Schenktronics/ST04-quad-mixer/docs/BOM.csv

Qty | Reference | Description | Manufacturer | Part Number | Link
1 | U1 | Quad JFET op-amp, SOIC-14. Must be the H version | Texas Instruments | TL074HIDR | https://www.ti.com/lit/ds/symlink/tl074.pdf
1 | U2 | Dual JFET op-amp, SOIC-8. Must be the H version | Texas Instruments | TL072HIDR
13 | R1-R4, R9-R17 | Resistor, 10k, 1%, 0805 | Yageo | RC0805FR-0710KL
4 | R5-R8 | Resistor, 0 ohm jumper, 0805 | Yageo | RC0805FR-070RL
6 | R18-R23 | Resistor, 1k, 1%, 0805 | Yageo | RC0805FR-071KL
4 | C1-C4 | Capacitor, 0.1uF, 25V, X7R, 0805 | AVX | 08053C104KAT2A
2 | C5, C6 | Capacitor, 10uF, 25V, X5R, 0805 | Taiyo Yuden | TMK212BBJ106KG-T
2 | C7, C8 | Capacitor, 10pF, 50V, C0G/NP0, 0805 | Yageo | CC0805JRNPO9BN100
2 | D1, D2 | Diode, 1A, 300V, SMA. Cathode (stripe) matters | ON Semiconductor | MRA4003T3G
8 | D3-D10 | Diode, 1N4148, SOD-323, 75V, 150mA. Cathode (stripe) matters | Diodes Incorporated | 1N4148WS-7-F | https://datasheet.octopart.com/1N4148WS-7-F-Diodes-Inc.-datasheet-7284054.pdf
2 | F1, F2 | Resettable fuse (PTC), 200mA hold, 30V, 1206 | Bel Fuse | 0ZCJ0020FF2E
1 | P1 | Shrouded pin header, 2x5, 2.54mm, vertical | On Shore Technology | 302-S101
6 | J1-J6 | 3.5mm mono switched jack, vertical, with nut (the oval pads also take panel-mount jacks such as CUI MJ-3507, with a wire from the sleeve lug to the square pad) | QingPu | WQP-PJ398SM or WQP518MA | http://www.qingpu-electronics.com/en/products/WQP-PJ398SM-362.html
4 | RV1-RV4 | Potentiometer, 100k linear, 6mm D shaft, no bushing | Bourns | PTV09A-4020F-B104 | http://www.farnell.com/datasheets/2259384.pdf
4 |  | Knob, fits 6mm D shaft (or equivalent) | Davies Molding | 1221-J
1 |  | Main PCB, 30x100mm, 2-layer, 1.6mm | Schenktronics | ST-04 Quad Mixer v1.0
1 |  | Faceplate, 6HP (30.48x128.5mm), 1.6mm aluminum PCB | Schenktronics | ST-04 Quad Mixer Faceplate
1 |  | Eurorack power cable, 10-pin to 16-pin
