Schenktronics/ST04-quad-mixer/hardware/mixer/4ch Mixer.step

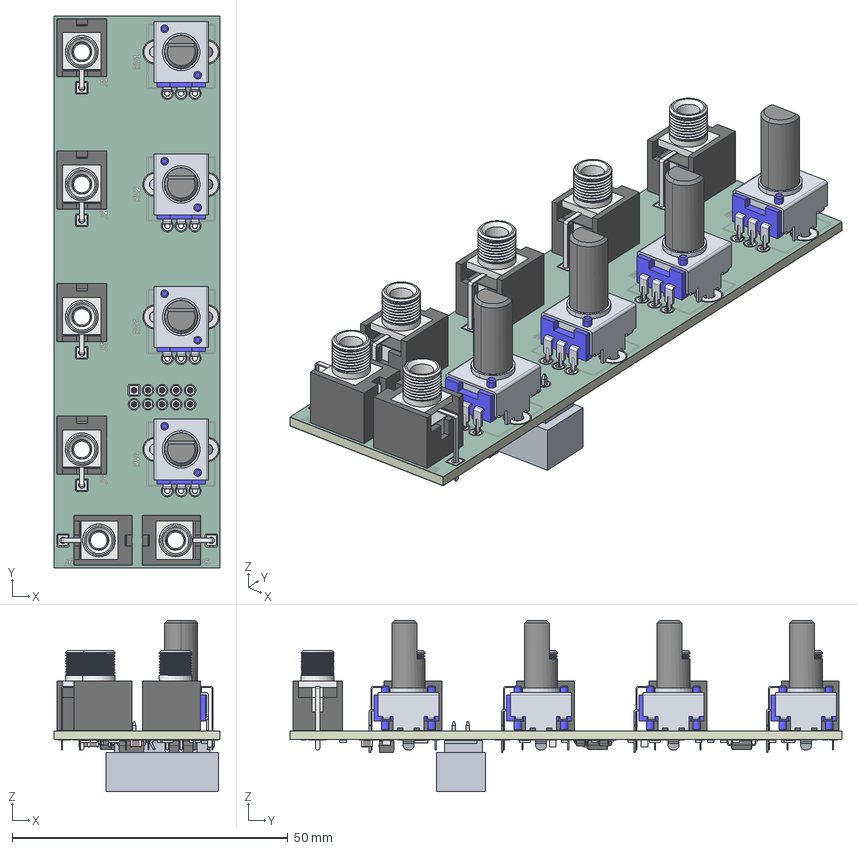
[picture p1: CAD file, 2026-11-01]
hardware/mixer/4ch Mixer.step
30.0 x 100.0 x 31.0 mm
Thonkiconn - PJ398SM v10 x 6
PTV09A-4X20F-XXXCX_2 x 4
PTV09A-4X20F-XXXCX x 4
C_0805_2012Metric x 8
R_0805_2012Metric x 23
D_SMA x 2
D_SOD-323 x 8
Fuse_1206_3216Metric x 2
SOIC-8_3.9x4.9mm_P1.27mm
SOIC-14_3.9x8.7mm_P1.27mm
4ch Mixer_copper
4ch Mixer_pad
4ch Mixer_via
4ch Mixer_silkscreen x 2
4ch Mixer_soldermask x 2
4ch Mixer_PCB
