Schenktronics/ST04-quad-mixer/hardware/panel/4ch Mixer Faceplate.step

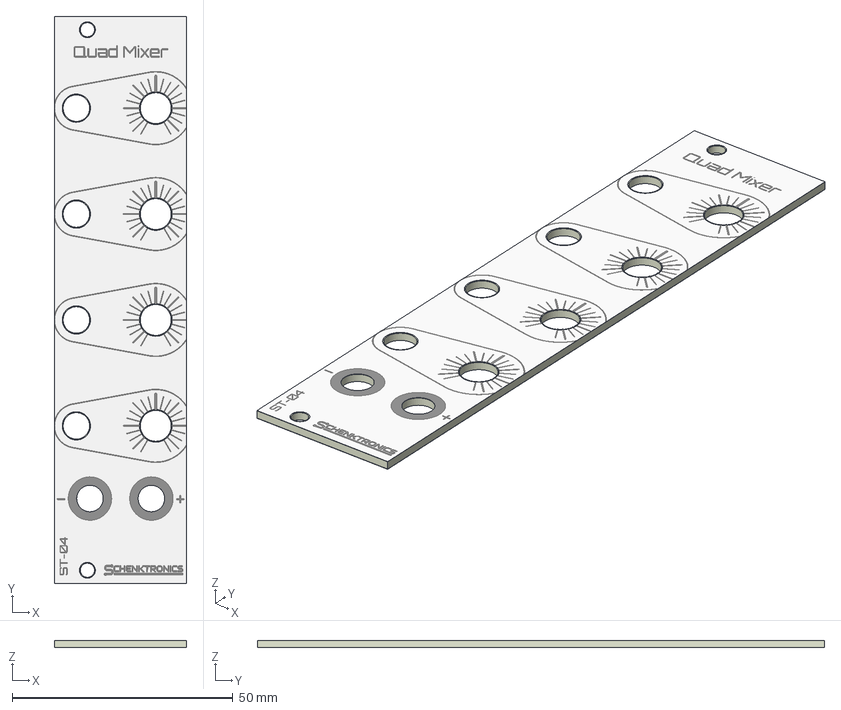
[picture p2: CAD file, 2026-11-01]
hardware/panel/4ch Mixer Faceplate.step
30.0 x 128.5 x 1.64 mm
4ch Mixer Faceplate_copper
4ch Mixer Faceplate_silkscreen
4ch Mixer Faceplate_soldermask x 2
4ch Mixer Faceplate_PCB
