Schenktronics/ST04-quad-mixer/hardware/ST-04_Quad Mixer.step

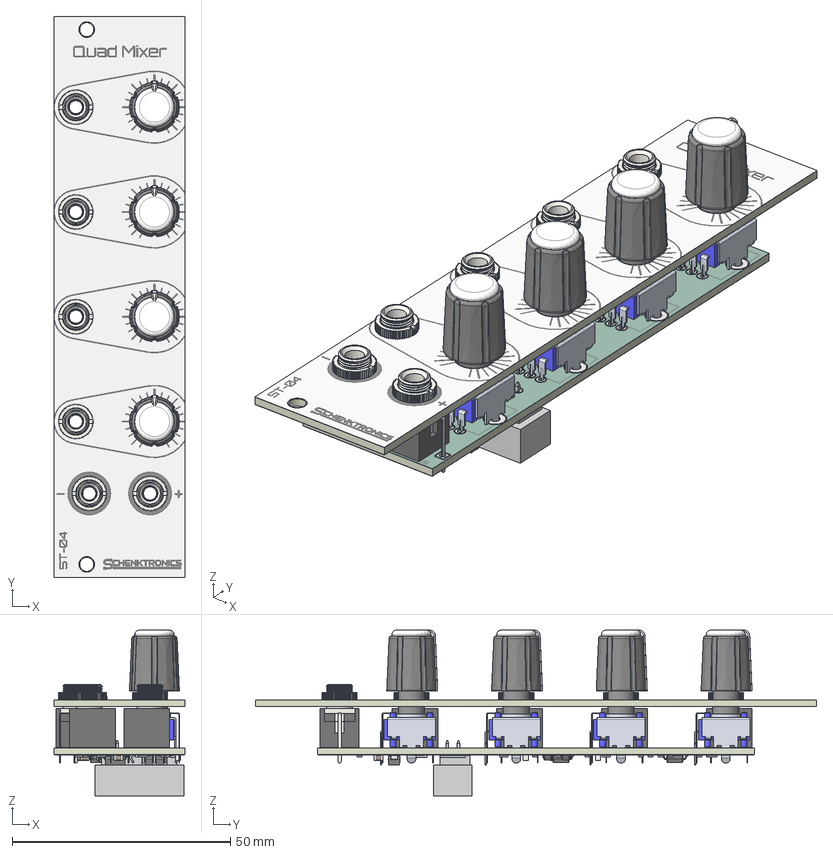
[picture p3: CAD file, 2026-11-01]
hardware/ST-04_Quad Mixer.step
30.0 x 128.5 x 38.0 mm
Thonkiconn - PJ398SM v10 x 6
PTV09A-4X20F-XXXCX_2 x 4
PTV09A-4X20F-XXXCX x 4
C_0805_2012Metric_1 x 8
R_0805_2012Metric_1 x 23
D_SMA_1 x 2
D_SOD-323_1 x 8
Fuse_1206_3216Metric_1 x 2
SOIC-8_3.9x4.9mm_P1.27mm_1
SOIC-14_3.9x8.7mm_P1.27mm_1
4ch Mixer_copper
4ch Mixer_pad
4ch Mixer_via
4ch Mixer_silkscreen
4ch Mixer_silkscreen_1
4ch Mixer_soldermask
4ch Mixer_soldermask_1
4ch Mixer_PCB
4ch Mixer Faceplate_copper
4ch Mixer Faceplate_silkscreen
4ch Mixer Faceplate_soldermask
4ch Mixer Faceplate_soldermask_1
4ch Mixer Faceplate_PCB
1221-J x 4
