Schenktronics/ST04-quad-mixer/hardware/mixer/4ch Mixer.kicad_pcb

## KiCad design hardware/mixer/4ch Mixer.kicad_pcb (2026-10-26)

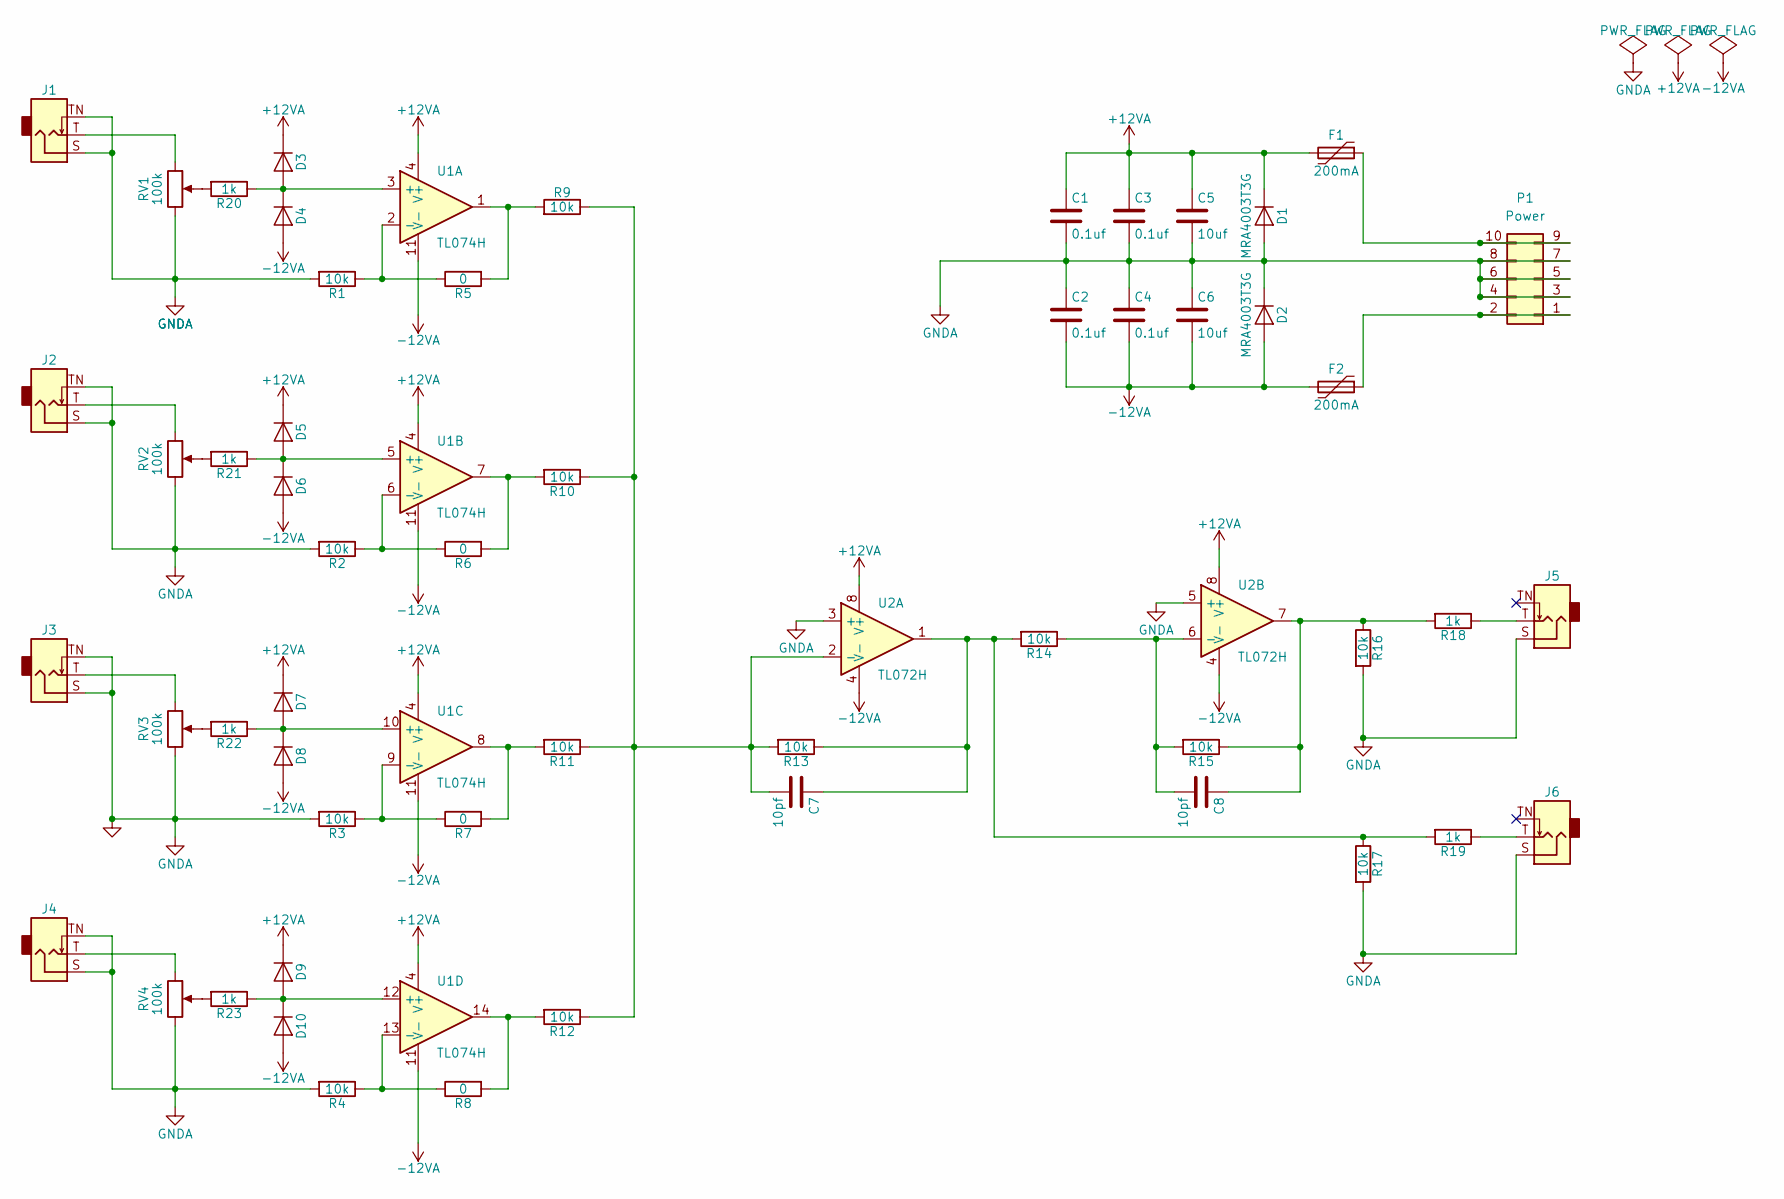
[picture p14: schematic 4ch Mixer.kicad_sch, Quad Mixer]

Parts:
C1, C2, C3, C4: 0.1uf; C_0805_2012Metric
C5, C6: 10uf; C_0805_2012Metric
C7, C8: 10pf; C_0805_2012Metric
D1, D2: MRA4003T3G; D_SMA
D3, D4, D5, D6, D7, D8, D9, D10: 1N4148; D_SOD-323
F1, F2: 200mA; Fuse_1206_3216Metric
J1, J2, J3, J4, J5, J6: Jack_3.5mm_QingPu_WQP-PJ398SM_Vertical_CenterHole_OvalPads
P1: Power; PinHeader_2x05_P2.54mm_Vertical_Shrouded
R1, R2, R3, R4, R9, R10, R11, R12, R13, R14, R15, R16, R17: 10k; R_0805_2012Metric
R5, R6, R7, R8: 0; R_0805_2012Metric
R18, R19, R20, R21, R22, R23: 1k; R_0805_2012Metric
RV1, RV2, RV3, RV4: 100k; Potentiometer_Alps_RK09L_Plated_Mount_Holes
U1: TL074H; SOIC-14_3.9x8.7mm_P1.27mm
U2: TL072H; SOIC-8_3.9x4.9mm_P1.27mm

Connections:
+12VA: C1.1, C3.1, C5.1, D1.1 (K), D3.1 (K), D5.1 (K), D7.1 (K), D9.1 (K), F1.2, U1.4 (V+), U2.8 (V+)
-12VA: C2.2, C4.2, C6.2, D2.2 (A), D4.2 (A), D6.2 (A), D8.2 (A), D10.2 (A), F2.2, U1.11 (V-), U2.4 (V-)
GNDA: C1.2, C2.1, C3.2, C4.1, C5.2, C6.1, D1.2 (A), D2.1 (K), J1.S, J1.TN, J2.S, J2.TN, J3.S, J3.TN, J4.S, J4.TN, J5.S, J6.S, P1.3, P1.4, P1.5, P1.6, P1.7, P1.8, R1.2, R2.2, R3.2, R4.2, R16.2, R17.2, RV1.3, RV2.3, RV3.3, RV4.3, U2.3 (+), U2.5 (+)
unnamed: D3.2 (A), D4.1 (K), R20.1, U1.3 (+)
unnamed: D5.2 (A), D6.1 (K), R21.1, U1.5 (+)
unnamed: D7.2 (A), D8.1 (K), R22.1, U1.10 (+)
unnamed: D9.2 (A), D10.1 (K), R23.1, U1.12 (+)
unnamed: J1.T, RV1.1
unnamed: J2.T, RV2.1
unnamed: J3.T, RV3.1
unnamed: J4.T, RV4.1
unnamed: J5.T, R18.1
unnamed: J6.T, R19.1
unnamed: F2.1, P1.1, P1.2
unnamed: F1.1, P1.9, P1.10
unnamed: R20.2, RV1.2
unnamed: R21.2, RV2.2
unnamed: R22.2, RV3.2
unnamed: R23.2, RV4.2
unnamed: R1.1, R5.1, U1.2 (-)
unnamed: R5.2, R9.2, U1.1
unnamed: R2.1, R6.1, U1.6 (-)
unnamed: R6.2, R10.2, U1.7
unnamed: R3.1, R7.1, U1.9 (-)
unnamed: R7.2, R11.2, U1.8
unnamed: R4.1, R8.1, U1.13 (-)
unnamed: R8.2, R12.2, U1.14
unnamed: C7.2, R9.1, R10.1, R11.1, R12.1, R13.2, U2.2 (-)
unnamed: C7.1, R13.1, R14.2, R17.1, R19.2, U2.1
unnamed: C8.2, R14.1, R15.2, U2.6 (-)
unnamed: C8.1, R15.1, R16.1, R18.2, U2.7

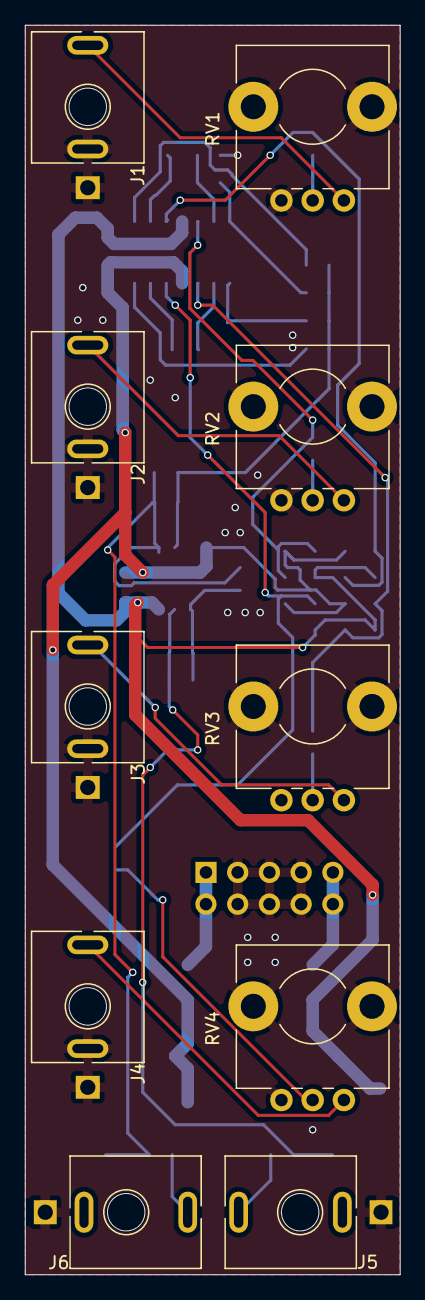
[picture p15: board 4ch Mixer.kicad_pcb from above]

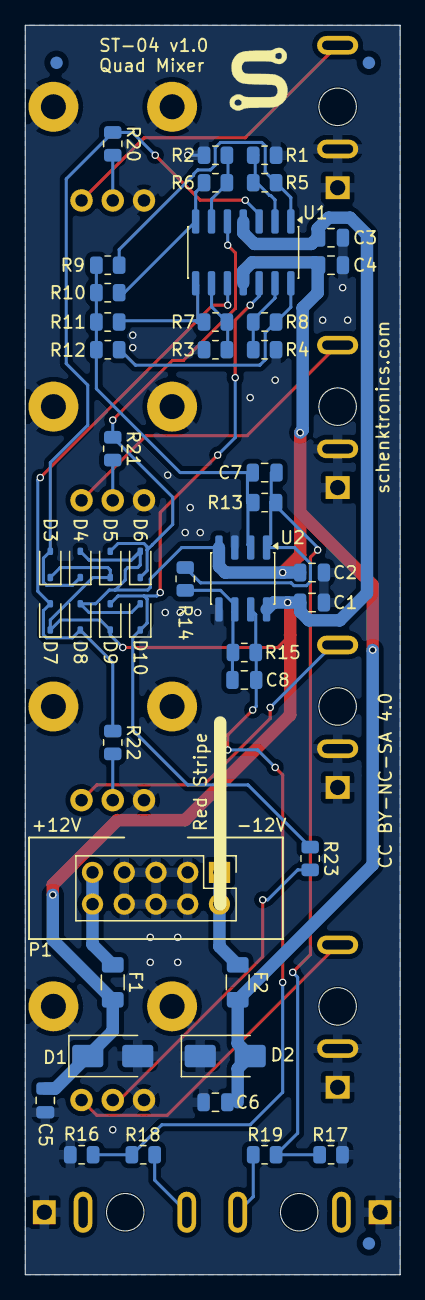
[picture p16: board 4ch Mixer.kicad_pcb from below]

Board: 2 copper layers, 30.0 x 100.0 mm, 59 parts (49 on the bottom side), 31 nets.

Other parts of the board:
FID1, FID2, FID3: Fiducial_1mm_Mask2mm
