Schenktronics/ST04-quad-mixer/(commit log)

2017-02-12 Initial Commit. Built prototype board and tested.
    [4ch Mixer.kicad_pcb, 4ch Mixer.sch]
2017-02-12 Added Faceplate and laser program
    [4chMixer.dxf]
2017-02-13 Renamed drawing to reflect hp use
    [4chMixer12hp.dxf]
2017-02-22 Added 100 ohm resistors to outputs. This is to prevent oscillations when using high capacitance cables.
    [4ch Mixer.sch]
2017-02-22 Added PTC fuses and protection diodes to schematic.
    Associated footprints.
    Started a PCB layout, need to update some footprints.
    [4ch Mixer.kicad_pcb, 4ch Mixer.sch]
2017-02-23 Continued work on PCB and Schematic
    [4ch Mixer.kicad_pcb, 4ch Mixer.sch]
2017-02-23 Worked on the PCB
    [4ch Mixer.dsn, 4ch Mixer.kicad_pcb]
2017-03-08 Created PCB. Need to look over carefully.
    Need to measure potentiometer footprint to ensure it is correct.
    [4ch Mixer.dsn, 4ch Mixer.kicad_pcb, _saved_4ch Mixer.sch]
2017-03-08 Made some gerbers.
    Need to redo the board layout to fit 12hp max.
    55mm x 100mm, or better yet 45mm x 100mm
    [4ch Mixer-B.Cu.gbr, 4ch Mixer-B.Fab.gbr, 4ch Mixer-B.Mask.gbr, 4ch Mixer-B.SilkS.gbr, 4ch Mixer-Edge.Cuts.gbr, 4ch Mixer-F.Cu.gbr, 4ch Mixer-F.Fab.gbr, 4ch Mixer-F.Mask.gbr]
2017-03-09 Moved Schematic/Board Layout to its own folder
    [4ch Mixer-B.Cu.gbr, 4ch Mixer-B.Fab.gbr, 4ch Mixer-B.Mask.gbr, 4ch Mixer-B.SilkS.gbr, 4ch Mixer-Edge.Cuts.gbr, 4ch Mixer-F.Cu.gbr, 4ch Mixer-F.Fab.gbr, 4ch Mixer-F.Mask.gbr]
2017-03-09 Build a new PCB layout with a smaller footprint
    [4ch Mixer.dsn, 4ch Mixer.kicad_pcb, 4ch Mixer.sch, _saved_4ch Mixer.sch]
2017-03-09 I think the board is done
    [4ch Mixer-B.Cu.gbr, 4ch Mixer-B.Fab.gbr, 4ch Mixer-B.Mask.gbr, 4ch Mixer-B.SilkS.gbr, 4ch Mixer-Edge.Cuts.gbr, 4ch Mixer-F.Cu.gbr, 4ch Mixer-F.Fab.gbr, 4ch Mixer-F.Mask.gbr]
2017-03-09 Minor edits. Added Gerbers.zip.
    [4ch Mixer.kicad_pcb]
2017-03-09 Added caps to final op amp feedback.
    Moved big bypass caps to backside of board.
    Added mounting hole.
    Generated new Gerbers
    [4ch Mixer-B.Cu.gbr, 4ch Mixer-B.Mask.gbr, 4ch Mixer-B.SilkS.gbr, 4ch Mixer-Edge.Cuts.gbr, 4ch Mixer-F.Cu.gbr, 4ch Mixer-F.Mask.gbr, 4ch Mixer-F.SilkS.gbr, 4ch Mixer-NPTH-drl_map.gbr]
2017-03-10 Created faceplate dwg
    [10hpFacePlate.dwg, 4ch Mixer.csv, 4ch Mixer.kicad_pcb, 4chMixer12hp.dxf]
2017-03-10 Created faceplate dxf.
    [10hpFacePlate.dxf]
2017-07-12 Initial Laser Work
    [10hpFacePlate.dxf]
2026-10-03 general commit for uncommitted work.
    [4ch Mixer-B.Cu.gbr, 4ch Mixer-B.Mask.gbr, 4ch Mixer-B.SilkS.gbr, 4ch Mixer-Edge.Cuts.gbr, 4ch Mixer-F.Cu.gbr, 4ch Mixer-F.Mask.gbr, 4ch Mixer-F.SilkS.gbr, 4ch Mixer-NPTH-drl_map.gbr]
2026-10-03 Migrate project to KiCad 10
    - Add project symbol and footprint library tables
    - Bundle custom symbols and footprints under Schematic/lib
    - Convert schematic and PCB to KiCad 10 format
    - Remap KiCad 4 library names to KiCad 10 equivalents
    - Schematic passes ERC with no violations
    [4ch Mixer.kicad_pcb, 4ch Mixer.kicad_sch]
2026-10-03 Point pin header at KiCad 10 3D model
    The legacy Pin_Headers.3dshapes path does not exist in KiCad 10.
    [4ch Mixer.kicad_pcb]
2026-10-03 Ignore macOS and KiCad local files
    Untrack .DS_Store and ignore KiCad per-user settings, local history,
    rescue backups and lock files.
2026-10-03 Remove power LED and its series resistor
    The LED indicator is not needed. Removes D3, R20 and their +12VA and
    GNDA power symbols.
    [4ch Mixer.kicad_sch]
2026-10-03 Ground input jack sleeves and switch contacts
    Pin 1 (sleeve) and pin 2 (switch) of J1-J4 and the R1-R4 input resistor
    ends are now tied to GNDA. Adds one GNDA symbol per channel at the
    junction corner.
    [4ch Mixer.kicad_sch]
2026-10-03 Add Attenuverter footprints to project library
    Jack (PJ398SM), pot (RK09L plated mount holes) and shrouded 2x05 header,
    copied from NTSFootprints.
2026-10-03 Use Attenuverter footprints and 10-pin shrouded header
    Assign 0805 passives, SOIC op amps, 1206 fuses, SMA diodes, electrolytic
    caps, NTS jack/pot footprints and the shrouded 2x05 header. Header pinout
    matches the Attenuverter: -12V on pins 1-2, GND on 3-8, +12V on 9-10.
    Power symbol names and jack symbol pins are unchanged for now.
    [4ch Mixer.kicad_sch]
2026-10-03 Use AudioJack2_SwitchT for the input and output jacks
    Pins renamed to S (sleeve), T (tip) and TN (switch) to match the
    PJ398SM footprint pads. Sleeves and input switch contacts stay on GNDA,
    tips keep their signal nets. Output switch contacts are unused.
    [4ch Mixer.kicad_sch]
2026-10-03 Generate SMD board placement from netlist
    tools/pcb: netlist-driven board generator and the 4ch mixer layout.
    Input jacks in a column beside their pots, pots 26 mm apart along the
    full 100 mm length, outputs on the right near the bottom. No routing yet.
    [4ch Mixer.kicad_pcb]
2026-10-03 Restore Attenuverter footprints on jacks and header
    Changing the jack and header symbols cleared their footprint fields.
    Reassign PJ398SM to J1-J6 and the shrouded 2x05 header to P1, then
    regenerate the board placement from the updated netlist.
    [4ch Mixer.kicad_sch]
2026-10-03 Placement tools: pcbgen, sexpr reader/writer, mixer layout (WIP)
    Layout is in progress: inputs and pots fit in the 30 mm width; the header
    and output jacks still conflict at the bottom edge.
2026-10-03 Place 4ch mixer board: pots right, inputs left, outputs in pot gaps
    Pots RV1-RV4 on the right at 24 mm pitch, input jacks J1-J4 beside their
    pots on the left, outputs J5/J6 in the gaps between pots 2-4, header P1 on
    the bottom edge. SMD parts are mirrored onto the back, packed around the
    through-hole parts. DRC: only the jack footprint's hole/mask clearance
    warnings remain (the Attenuverter has the same ones). No routing yet.
    [4ch Mixer.kicad_pcb]
2026-10-03 WIP: back-side placement support and header search
    pcbgen: mirrors back-side parts, packs SMD on the back around through-hole
    courtyards, per-part side overrides. layout: header P1 on the back at the
    top left; still has one pad-in-courtyard clash with RV1 (not resolved).
2026-10-03 Board placement for hand tuning (DRC errors remain)
    Header P1 on the back at the top left, outputs J5/J6 in the lower right,
    pots 24 mm apart. Remaining DRC errors are listed for manual placement
    fixes. Not routed.
    [4ch Mixer.kicad_pcb]
2026-10-03 Use the Attenuverter's jack footprint orientation
    The newer NTS jack footprint defines its pads at 180 degrees; the
    Attenuverter board uses 270, so the oval holes were 90 degrees off. Replace
    the project copy with the Attenuverter's version. Also stop writing a
    second UUID on each pad in the generator. Board regenerated: only the
    pot 1 / header courtyard clash remains.
    [4ch Mixer.kicad_pcb]
2026-10-03 Put reference and value labels on the side each part is mounted on
    Back-mounted parts (SMD and header) had their labels on F.SilkS/F.Fab.
    They now use B.SilkS/B.Fab so they sit with their footprints.
    [4ch Mixer.kicad_pcb]
2026-10-03 Align pots and input jacks into columns at 24 mm pitch
    Pots RV1-RV4 in one column at x=125.5, input jacks J1-J4 in one column at
    x=105, both at y = 63, 87, 111, 135. Hand placement otherwise kept. DRC: no
    errors.
    [4ch Mixer.kicad_pcb]
2026-10-03 Level pot centres with the input jack centres
    Moved RV1-RV4 down 1.02 mm so each pot's graphical circle is on the same
    horizontal line as its jack's centre circle.
    [4ch Mixer.kicad_pcb]
2026-10-03 Arrange the resistors and capacitors near their connections
    place_rest.py places movable parts at the free spot nearest the centroid of
    the parts they are wired to, keeping hand-placed parts fixed. Also stop
    tracking __pycache__. DRC: no errors.
    [4ch Mixer.kicad_pcb]
2026-10-03 Optimise resistor and capacitor placement for short wires
    anneal_place.py minimises total wire length (ground excluded, since it goes
    to a pour; rails weighted lower) with 1 mm spacing for hand soldering. Fixes
    the back-side transform in pcbgen: KiCad mirrors back parts and rotates them
    by -rot, checked against the drill file. DRC: no errors.
    [4ch Mixer.kicad_pcb]
2026-10-03 Keep resistors and capacitors at 0 degrees; fix pad angles in the generator
    Rotated SMD parts had unrotated pad shapes: KiCad stores each pad's angle
    including the part rotation, and the generator did not write it. The
    generator now does, and the optimiser no longer rotates parts (default).
    All resistors and capacitors are at 0 degrees. DRC: no errors.
    [4ch Mixer.kicad_pcb]
2026-10-03 Refill zones, align passive columns and spacing, place reference labels
    Refilled the GNDA zones (stale fill caused the zone clearance errors),
    snapped passive columns to a common x and evenly spaced each run, and
    moved the back-side reference labels next to their parts. DRC: no errors
    except the pot mounting pads near the board edge (pot placement, not
    touched here) and some remaining label/silkscreen overlaps.
    [4ch Mixer.kicad_pcb]
2026-10-03 Routed SMD board
    Hand-arranged placement and routing from KiCad, with the schematic missing
    connections fixed by hand. The jack footprint uses the Attenuverter's
    orientation. DRC: no unconnected items; only the three accepted thermal
    spoke warnings remain.
    [4ch Mixer.kicad_pcb, 4ch Mixer.kicad_sch]
2026-10-03 Clean up fab layer: remove duplicate reference text, hide passive values
    Removed the library reference text copies on F.Fab/B.Fab (they duplicated
    the reference labels) and hid the value text on the resistors and
    capacitors. Values stay in the schematic and BOM. DRC: no new errors.
    [4ch Mixer.kicad_pcb]
2026-10-03 Add front panel PCB for the mixer
    6HP panel generated from the mixer board: unplated holes for pot shafts (7 mm)
    and jacks (6 mm) on the footprint circles, M3 mounting holes, pot tick marks,
    bold output jack rings, a solid copper pour on the front, and the Schentronics
    logo at the Attenuverter's offset. Centred on the board. DRC: no errors.
    [4ch Mixer Faceplate.kicad_pcb]
2026-10-03 Match mounting hole positions to the Attenuverter faceplate
    Holes at 7.5 mm and 22.75 mm from the panel's left edge and 3 mm from the top
    and bottom, as on the Attenuverter. DRC: no errors.
    [4ch Mixer Faceplate.kicad_pcb]
2026-10-03 Group each input jack with its pot on the front panel
    Per channel: a ring around the pot and one around the jack, joined by
    tangent lines at top and bottom, with the inner arcs trimmed so each pair
    reads as one oblong outline, as on the Attenuverter. The pot ring is
    clipped by the panel edge, as on the Attenuverter. DRC: no errors.
    [4ch Mixer Faceplate.kicad_pcb]
2026-10-03 Update front panel project file from KiCad
2026-10-03 Add module title and output polarity symbols to the front panel
    Title 'Quad Mixer' at the Attenuverter's size, italic, centred 7.85 mm below
    the top edge. + to the left of the non-inverting output J5 and - to the right
    of the inverting output J6. Also hides the placeholder reference on the logo.
    DRC: no errors.
    [4ch Mixer Faceplate.kicad_pcb]
2026-10-03 Add input clamp protection and Schentronics logo footprints
    Schematic: 1N4148 clamps and 1k series resistors on the inputs.
    Library: all four Schentronics logo variants from NTSFootprints.
    [4ch Mixer.kicad_pcb, 4ch Mixer.kicad_sch]
2026-10-04 Align passives, add back-side fiducials, and fix routing
    Snapped resistor and capacitor columns and rows to shared positions, added
    three 1 mm fiducials on the back, and rerouted the affected nets.
    DRC: no unconnected items; only starved-thermal warnings remain.
    [4ch Mixer.kicad_pcb]
2026-10-04 Align reference designator labels by column
    Each column of resistors and capacitors uses one label side and offset.
    Silkscreen warnings remain where labels sit over neighbouring pads.
    [4ch Mixer.kicad_pcb]
2026-10-04 Remove duplicate reference text from the back fab layer
    Diodes and vertical resistors carried a ${REFERENCE} text item on B.Fab that
    duplicated their reference labels. DRC silkscreen warnings drop from 22 to 11.
    [4ch Mixer.kicad_pcb]
2026-10-04 Add manufacturing files and set rail diodes to MRA4003T3G
    Manufacturing: Gerbers and drill for the mixer PCB and front panel, BOMs
    (SMD for the fab, hand assembly), and placement files. Schematic: D1 and D2
    changed to MRA4003T3G to match the fab BOM.
    [4ch Mixer Faceplate-Edge_Cuts.gm1, 4ch Mixer Faceplate-F_Cu.gtl, 4ch Mixer Faceplate-F_Mask.gts, 4ch Mixer Faceplate-F_Silkscreen.gto, 4ch Mixer Faceplate-job.gbrjob, 4ch Mixer Faceplate.drl, 4ch Mixer-B_Cu.gbl, 4ch Mixer-B_Mask.gbs]
2026-10-04 Exclude the logo from placement and BOM exports
    Logo footprint marked board-only; placement file regenerated with 48 entries
    (45 SMD parts plus three fiducials).
    [4ch Mixer.kicad_pcb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]
2026-10-04 Restructure repo and remove KiCad 4/5 leftovers
    Layout: hardware/mixer and hardware/panel (KiCad 10 projects with their
    libraries), manufacturing/ (Gerbers, drill, BOMs, placement), tools/, and a
    README. Removed the legacy KiCad 4/5 schematic, netlist, cache and Gerber
    files, and the superseded 10 HP faceplate drawings (still in history).
    [10hpFacePlate.dwg, 10hpFacePlate.dxf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]
2026-10-04 Add user manual, assembly guide, BOM and drawings
    The README now covers both versions (assembled and the Easy Build Kit with
    SMD parts pre-soldered). The docs describe the circuit as the netlist
    shows it: each channel is a 100k pot with a ×2 gain stage, the summed
    output runs through two inverters to a + and a − jack, and empty inputs
    are grounded by the switched jacks.
    The drawings are generated from the KiCad files by stdlib-only scripts
    that read the S-expression format directly. The PDF build is set to run on
    main.
    [BOM.csv]
2026-10-04 Swap + and - output positions on the panel; trim pot ring at the edge
    Board: J5 (non-inverting, +) is on the right and J6 (inverting, -) on the left,
    after the designator and net swap. Panel: + to the right of the J5 hole, -
    to the left of the J6 hole. Pot outer rings are cut at the panel edge.
    [4ch Mixer Faceplate.kicad_pcb, 4ch Mixer.kicad_pcb]
2026-10-04 Change pots to 10k (Panasonic EVU-F3AF20B14) and regenerate manufacturing files
    Schematic: RV1-RV4 set to 10k, same footprint. Hand-assembly list updated with
    the Panasonic part. Regenerated Gerbers, drill, placement and BOM for both boards.
    [4ch Mixer Faceplate-Edge_Cuts.gm1, 4ch Mixer Faceplate-F_Cu.gtl, 4ch Mixer Faceplate-F_Mask.gts, 4ch Mixer Faceplate-F_Silkscreen.gto, 4ch Mixer Faceplate-job.gbrjob, 4ch Mixer Faceplate.drl, 4ch Mixer-B_Cu.gbl, 4ch Mixer-B_Mask.gbs]
2026-10-05 4ch Mixer: docs and drawings update; diode rating 300 V
    Manual, assembly guide, BOM and drawings brought up to date. MRA4003T3G
    is 300 V per the datasheet, so the BOM and fab BOM now say 300 V.
    [BOM.csv, mixer-bom-smd-fab.csv]
2026-10-05 4ch Mixer: depth is 20 mm, same as the Attenuverter
2026-10-05 Rename product to Quad Mixer
    Display names, manual, assembly guide, BOM, panel titles and PDF config
    now say Quad Mixer, and the repo is schenkzoola/Quad-Mixer. File and
    folder names are unchanged.
    [BOM.csv]
2026-10-05 Rebuild manual and assembly guide PDFs for the Quad Mixer name
2026-10-07 Faceplate: trim to true 30mm (6HP at 5.0mm/HP), matching the main PCB
    Was 30.48mm (5.08mm/HP, the official Eurorack spec), inconsistent with
    the rest of the lineup and with the main PCB, which was already 30mm.
    Trimmed 0.24mm off each edge, keeping the same centerline (X=115.0) as
    the main board. Checked every hole, jack, pot and the wordmark against
    the new edges first — nearest is the '+' text at 1.45mm clear, nothing
    clips.
    [4ch Mixer Faceplate.kicad_pcb]
2026-10-07 Faceplate: squeezed wordmark footer, Orbitron text
    Replaces the lower-left S-mark with the 2mm-squeezed full wordmark
    (_NTSFootprints:SchentronicsLogoSqueeze2mm), centered in the gap right
    of the bottom screw hole (0.92mm margin each side). Adds ST-04, vertical,
    centered in the left gap, anchored to the wordmark's bottom. Header and
    part number switched from italic KiCad stroke font to upright Orbitron.
    Note: this file carries other pending local changes from before this
    edit, not just the faceplate update above.
    [4ch Mixer Faceplate.kicad_pcb]
2026-10-07 Faceplate: align mounting-hole X-offset to 7.5mm, re-anchor wordmark/ST-04
    Both rack-screw holes move from 7.26mm off the left edge to exactly
    7.5mm, matching the Attenuverter and the two 3 HP boards -- this board's
    holes were 0.24mm further left than the Attenuverter's, a real mismatch,
    not rounding. Wordmark and ST-04 shift by the same 0.12mm to stay
    centered off the new hole position.
    [4ch Mixer Faceplate.kicad_pcb]
2026-10-07 Faceplate: move header to the common 8.25mm top offset
    Matches the Attenuverter, Multiple and Attenuator rather than the old
    7.85mm. Also widens the margin between the header text and the top
    screw head from 0.35mm to 0.75mm -- Orbitron's width means the text's
    left edge already runs past the hole horizontally, so that vertical
    gap was the only real clearance. Docs regenerated from the updated file.
    [4ch Mixer Faceplate.kicad_pcb]
2026-10-07 Title blocks: logo worksheet, consistent company/rev across PCB and schematic
    Repoint page_layout_descr_file (both pcbnew and schematic) to the real
    Schenktronics worksheet path on this machine. Fill out/correct title
    blocks: company standardized to "Schenktronics" (was "SchenkTronics"),
    schematic rev brought from the letter "A" to "1.0" to match the real
    "V1.0" silkscreen text and the new PCB title block, schematic title
    aligned to "Quad Mixer" to match the board. Faceplate matched to the
    same 1.0.
    [4ch Mixer Faceplate.kicad_pcb, 4ch Mixer.kicad_pcb, 4ch Mixer.kicad_sch]
2026-10-07 Title block: add Dolibarr PCB ref (PCB-ST04-MAIN / PCB-ST04-FACE) as comment 4
    [4ch Mixer Faceplate.kicad_pcb, 4ch Mixer.kicad_pcb, 4ch Mixer.kicad_sch]
2026-10-07 Main PCB: harmonize branding text with the Multiple's pattern
    Reformatted the combined "Quad Mixer\nV1.0\nschenktronics.com" to
    "ST-04 v1.0\nQuad Mixer\nschenktronics.com" (code + version leading,
    matching the other boards' convention). Kept it on the front where it
    already had a clear, proven spot -- tried moving it to the back to
    match the Multiple/Attenuverter/Attenuator convention, but this board's
    back is routed edge to edge with no clear pocket that size; moving it
    there just put it on top of real traces. Logo (medium S-mark) unchanged.
    Also tried adding the CC BY-NC-SA roundels, same result as the
    Attenuverter -- no space without overlapping copper, left off.
    [4ch Mixer.kicad_pcb]
2026-10-07 Main PCB: hand-placed branding text on the back, add CC license text
    Nathan's own edit in KiCad: moved the ST-04/Quad Mixer text from the
    front to a clear spot on the back, and added "CC BY-NC-SA 4.0" text
    (matching the other boards -- text only, no icon roundels).
    [4ch Mixer.kicad_pcb]
2026-10-08 Regenerate gerbers: harmonized branding, Protel extensions preserved
    Main board picks up the harmonized ST-04 branding text (moved to the
    back, with CC license text). Faceplate picks up the squeezed wordmark,
    tick marks, and the 7.5mm hole-offset fix.
    The board file's saved plot settings say "no gerber extensions," but
    the existing committed gerbers use Protel extensions (.gtl/.gbl/etc) --
    used an explicit layer list + Protel extensions to match what's
    actually here rather than trust that stored (apparently stale) setting.
    [4ch Mixer Faceplate-Edge_Cuts.gm1, 4ch Mixer Faceplate-F_Cu.gtl, 4ch Mixer Faceplate-F_Mask.gts, 4ch Mixer Faceplate-F_Silkscreen.gto, 4ch Mixer Faceplate-job.gbrjob, 4ch Mixer Faceplate.drl, 4ch Mixer-B_Cu.gbl, 4ch Mixer-B_Mask.gbs]
2026-10-09 Fix library reference, add 3d models
    [4ch Mixer Faceplate.kicad_pcb, 4ch Mixer Faceplate.step, 4ch Mixer.kicad_pcb, 4ch Mixer.step, ST-04_Quad Mixer.step]
2026-10-09 Drop channel gain to ×1, swap pots to 100k, add STEP-based outline drawings
    Each channel's op-amp (U1) was wired for ×2 gain, with the pot giving
    0-2x overall and unity at its center click. Changed R5-R8 (feedback
    resistors) from 10k to 0R, making each stage a unity-gain buffer, so
    the range is now 0-1x with no gain above the input's own level. R1-R4
    stay at 10k; reverting a channel to ×2 just needs its R5-R8 swapped
    back to 10k. This also raises per-channel clipping headroom from
    ±5V to the full ±10V op-amp swing, since nothing is thrown away by a
    later attenuation stage. Updated the manual, assembly guide, README,
    BOM/manufacturing CSVs and the generated panel/patch drawings to
    match.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
    [4ch Mixer.kicad_pcb, 4ch Mixer.kicad_sch, BOM.csv, mixer-bom-smd-fab.csv, mixer-bom-tht-handsolder.csv, mixer-bom.csv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]
2026-10-09 Stop tracking generated manufacturing files
    [4ch Mixer Faceplate-Edge_Cuts.gm1, 4ch Mixer Faceplate-F_Cu.gtl, 4ch Mixer Faceplate-F_Mask.gts, 4ch Mixer Faceplate-F_Silkscreen.gto, 4ch Mixer Faceplate-job.gbrjob, 4ch Mixer Faceplate.drl, 4ch Mixer-B_Cu.gbl, 4ch Mixer-B_Mask.gbs]
2026-10-17 Regenerate the ST-04 drawings, fix the panel's rotated text
    The panel drawing drew the rotated "ST-04" text unrotated, so it ran
    off the panel's left edge. The panel script now applies the text's
    rotation and justification.
    The assembly drawings pick up the board's back silkscreen, and the
    surface-mount drawing is dropped, since kits ship with those parts
    soldered. Labels and titles use keyboard punctuation ("Out -",
    straight quotes) and American spelling, including code comments in the
    panel generator.
2026-10-17 Polish the ST-04 Quad Mixer docs for launch: through-hole build only
    Every board ships with its surface-mount parts soldered by the board
    house and tested, so the assembly guide drops the SMD soldering step
    and per-diode checks and covers the 48 through-hole joints, keeping the
    power-rail short check.
    Fixes: the current draw was a placeholder, now "up to 20 mA per rail"
    until it's measured; the panel has two rack screw holes, not four; the
    board text is all on the back ("ST-04 v1.0 / Quad Mixer"); the README
    said SMD parts are on both sides, but they're all on the back; and an
    image description said eight jacks instead of six.
    Titles use "ST-04 Quad Mixer", the PDFs are renamed to
    ST-04_Qu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
    [BOM.csv]
2026-10-17 Keep the repo customer-facing: move build tooling out
    The drawing scripts moved to the private schenktronics-business repo
    (products/ST04-quad-mixer/drawings/), and still write into docs/images/ here. The board and panel generators in tools/ moved too.
    The PDF build settings moved from docs/pdf/config.json to
    .github/pdf-config.json, so docs/pdf/ holds only the PDFs, and its
    README is gone. The README's repository layout lists only the product.
2026-10-17 Square up the jacks before soldering, snug the nuts last
    Nathan's refined build order: hand-tighten the jack nuts, square up the
    jack bodies with small pliers, center the parts, solder everything, and
    only then snug the nuts down. The faceplate drawing's caption now reads
    "..., solder, then tighten the nuts", and its nut label says
    "hand-tighten first".
2026-10-17 Add solder and lead-handling advice to the assembly guide
    The Tools list asks for 0.8 mm flux-core solder and safety glasses,
    without recommending leaded or lead-free, and the iron line notes that
    lead-free runs a little hotter. "First time soldering?" says 63/37 or
    60/40 leaded solder is easier to learn with and leaves the choice to
    the builder, with handling advice for leaded solder (wash hands, no
    eating, drinking, or smoking while soldering, wipe the work surface,
    keep it away from kids) and a separate note on ventilation and flux
    fumes.
2026-10-17 Explain the oval jack pads with the CUI MJ-3507, drop the Mouser project
    The jack pads are oval so the board also takes panel-mount style jacks.
    The README, the BOM's jack row, and a new "Using panel-mount style
    jacks?" note in the assembly guide now say so with one example, the
    CUI MJ-3507, whose sleeve is a solder lug that needs a short wire to
    the square pad. QingPu stays the main part in the BOM.
    The out-of-date Mouser project link and the BOM's "Ordering the
    parts" section are removed.
    [BOM.csv]
2026-10-17 Draw the slotted jack holes in the assembly drawings
    Oval drills were skipped, so the jack pads were drawn solid. They're now
    drawn as slots, lined up with their pads.
2026-10-17 Put the receiving module on the right in the inverted-output patch
    Destinations go on the right, with an arrow, as in the other products'
    patch drawings. The cable from the - output runs under the + jack to
    reach the Filter.
2026-10-20 Panel width is 30 mm, not 30.48
    The faceplate's board outline and Gerbers are 30.00 x 128.5 mm, the usual
    6HP panel width (a little under 6 x 5.08 mm so neighbors fit). 30.48 came
    from the panel generator's nominal width.
2026-10-26 Use TL074H and TL072H op-amps
    A TL074CDR or TL072CDR can come from TI's legacy die, which only
    guarantees input common-mode range to about 4 V above the negative rail
    (about -8 V on -12 V) and phase-reverses past it. The U1 buffers follow
    the input signal, so a hot negative input with a knob near full could
    flip a buffer's output to the positive rail. The H die works down to
    V- + 1.5 V, doesn't phase-reverse, and swings closer to the rails. It's
    a drop-in part in the same SOIC packages.
    The BOM now calls for TL074HIDR and TL072HIDR, and the schematic and
    PCB values say TL074H and TL072H so the fab BOM export matches.
    [4ch Mixer.kicad_pcb, 4ch Mixer.kicad_sch, BOM.csv]
2026-11-01 Faceplate: save the F.Cu pour's fill, back shows as aluminum in 3D; re-export STEP files
    [4ch Mixer Faceplate.kicad_pcb, 4ch Mixer Faceplate.step, 4ch Mixer.step]
2026-11-01 Assembly STEP from Fusion: new 1221-J knobs, current board and faceplate
    [ST-04_Quad Mixer.step]
